mahmoodjanabi/tiny-engineer/mods/round-face/round_face_sections.png

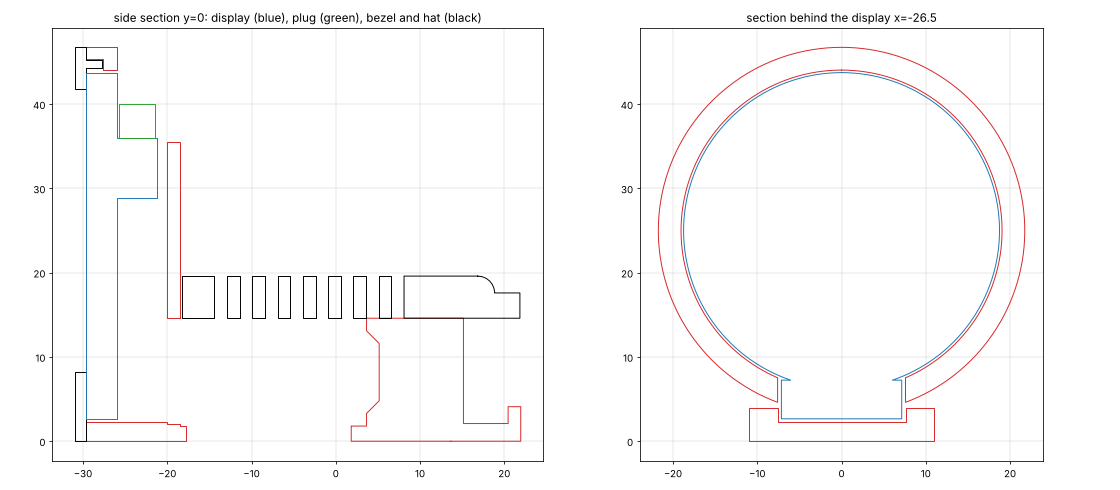
mods/round-face/round_face_sections.png
