mahmoodjanabi/tiny-engineer/mods/round-face/3d_models/parts/sg90/3mf/HatRound.3mf

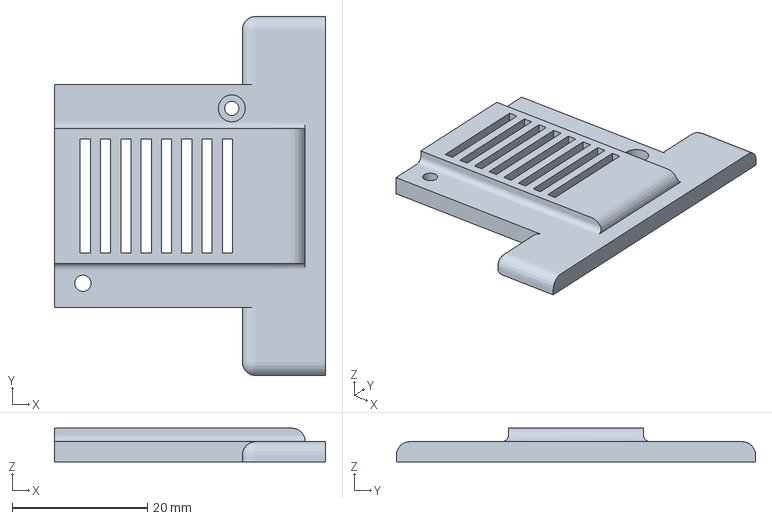
[picture p3: CAD file, 2026-11-08]
mods/round-face/3d_models/parts/sg90/3mf/HatRound.3mf
40.0 x 53.1 x 5.00 mm
