mahmoodjanabi/tiny-engineer/mods/round-face/3d_models/parts/sg90/3mf/BezelRound.3mf

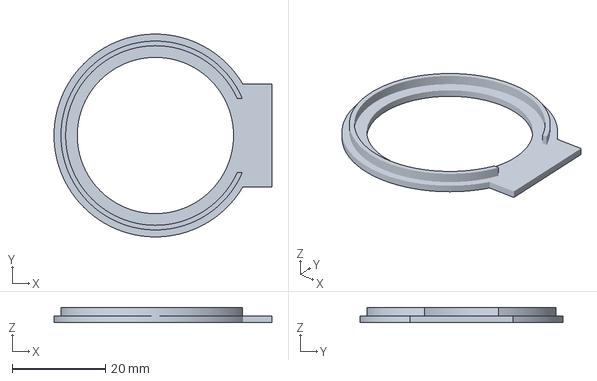
[picture p4: CAD file, 2026-11-08]
mods/round-face/3d_models/parts/sg90/3mf/BezelRound.3mf
46.8 x 43.5 x 3.30 mm
