mahmoodjanabi/tiny-engineer/mods/round-face/3d_models/parts/sg90/3mf/HeadRound.3mf

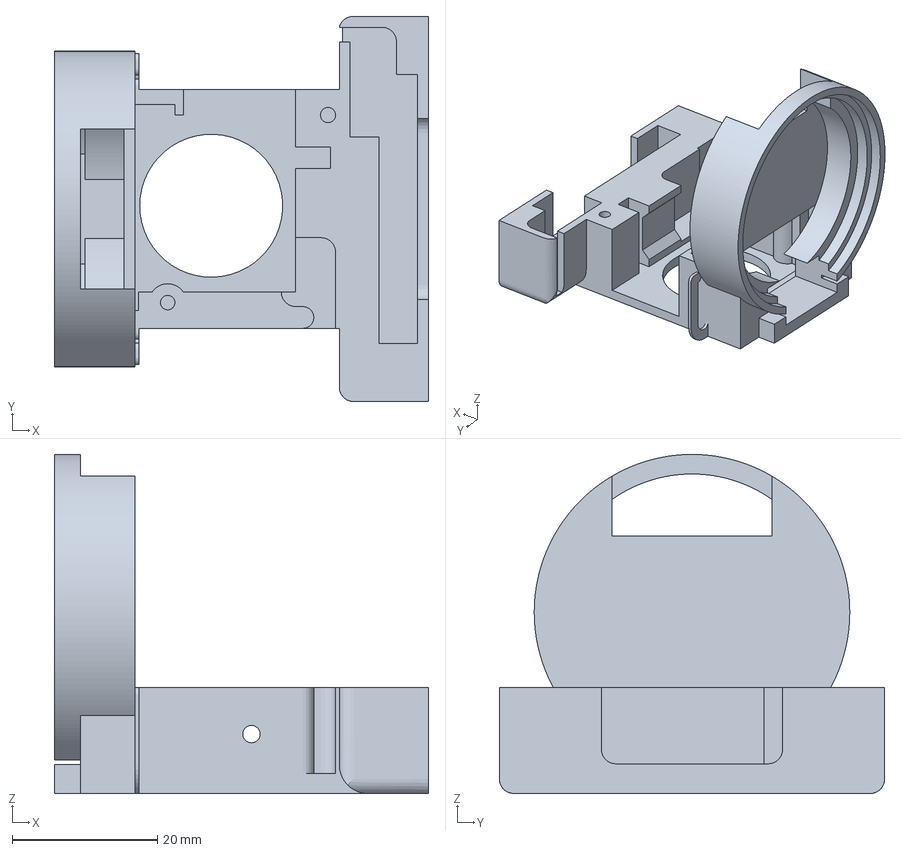
[picture p5: CAD file, 2026-11-08]
mods/round-face/3d_models/parts/sg90/3mf/HeadRound.3mf
51.6 x 53.1 x 46.8 mm
