mahmoodjanabi/tiny-engineer/(list of files, cad)

Other CAD files:
mods/round-face/3d_models/parts/sg90/stl/BezelRound.stl
mods/round-face/3d_models/parts/sg90/stl/HatRound.stl
mods/round-face/3d_models/parts/sg90/stl/HeadRound.stl
