mahmoodjanabi/tiny-engineer/(commit log)

2026-11-07 feat(mods): add round-face head for a 1.28" GC9A01 display
    HeadRound and HatRound replace stock Head and Hat. The stock head mesh is
    kept except for the OLED front wall; a round housing for the Waveshare
    1.28inch LCD Module is grafted on. Mechanical only: firmware support for
    the GC9A01 is not included.
    Claude-Session: https://claude.ai/code/session_01DBugKDgeqmLwUq3dYQQ5Gh
    [HatRound.3mf, HatRound.stl, HeadRound.3mf, HeadRound.stl]
2026-11-07 feat(scripts): add tiny-say voice script for spoken hook lines
    Text to TTS (macOS say, piper, or espeak-ng) to 22050 Hz mono WAV to
    POST /play, cached by text. --event picks a line per Claude Code hook
    event and names the project, so Stop says "Done, human. <project> is
    ready." while the firmware animates to the audio.
    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
2026-11-08 fix(mods): make round-face head assemblable with a front bezel
    v1 could not be assembled: the bezel was part of the head and the back
    was closed, so the 37.5 mm display could not reach its pocket, and the
    cable exit was modelled at the bottom when the socket faces up at the top.
    v2 loads the display from the front and clamps it with a separate
    press-fit BezelRound, adds a cable slot at the top-back, and models the
    module from Waveshare's drawing. check_round_face.py verifies seating,
    the insertion path, bezel, hat and cable clearance with booleans.
    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
    [BezelRound.3mf, BezelRound.stl, HatRound.3mf, HatRound.stl, HeadRound.3mf, HeadRound.stl]
